lashbits/silicon-toaster/py/README.md

# silicontoaster python package

This is a python package for interacting with a Silicon Toaster device.
