lashbits/silicon-toaster/hw/updated_bom.pdf

Refs | Value | Quantity | SKU | Sinuss | Digikey | Price Sinuss | Price Digikey
C1, C2, C3, C4, C5, C8, C9, C16, C17, C42 | 0.1uF, 25V | 10 | MC0603B104K250CT | 1759037 (https://sinuss.nl/products/mc0603b104k250ct-cap-01uf-25v-10-x7r-0603-multicomp-pro) | not listed alternatives (https://www.digikey.nl/short/33pb599q) my choice (https://www.digikey.nl/nl/products/detail/kyocera-avx/LD033C104KAB2A/1564728) | 1.5€
C6, C7, C10, C11, C12, C13, C14 | 2.2uF | 7 | GRM188R61E225KA12D | 1845734 (https://sinuss.nl/products/grm188r61e225ka12d-cap-22uf-25v-10-x5r-0603-murata) | 490-10731-2-ND (https://www.digikey.nl/nl/products/detail/murata-electronics/GRM188R61E225KA12D/4905349) | 1.1€ | 0.91€
C15 | 22uF | 1 | GRM21BR61E226ME44L | 1907510 (https://sinuss.nl/products/grm21br61e226me44l-cap-22uf-25v-20-x5r-0805-murata) | 490-10749-2-ND (https://www.digikey.nl/nl/products/detail/murata-electronics/GRM21BR61E226ME44L/4905535) | 0.36€ | 0.34€
C18, C19, C20, C21 | 0.15uF | 4 | C2225X154KDRACTU | 2676668 (https://sinuss.nl/products/c2225x154kdractu-cap-015uf-1-kv-10-x7r-2225-kemet) | 399-C2225X154KDRAC7800TR-ND (https://www.digikey.nl/nl/products/detail/kemet/C2225X154KDRAC7800/4172917) | 15.52€ | 11.44€
C22, C23, C24, C25, C26, C27, C28, C29, C30, C31, C32, C33, C34, C35, C36, C37, C38, C39, C40, C41 | 0.1uF | 20 | C2225C104KFRACTU | 2676659 (https://sinuss.nl/products/c2225c104kfractu-cap-01uf-15-kv-10-x7r-2225-kemet) | 399-C2225C104KFRAC7800TR-ND (https://www.digikey.nl/nl/products/detail/kemet/C2225C104KFRAC7800/4172913) 399-18116-2-ND (https://www.digikey.nl/nl/products/detail/kemet/C2225C104KFRACAUTO/9343294) | 104.39€ | 43.46€
D1, D2, D3, D4, D6, D9 | 1A 800V | 6 | US1K-E3/61T | 2335178 (https://sinuss.nl/products/us1k-e361t-rectifier-fast-1a-800v-do-214ac-2-vishay) | US1K-E3/61TGITR-ND (https://www.digikey.nl/nl/products/detail/vishay-general-semiconductor-diodes-division/US1K-E3-61T/1119543) | 3.54€ | 2.04€
D5 | 40V 1A | 1 | MBRM140T3 | 1459068 (https://sinuss.nl/products/mbrm140t3g-diode-schottky-1a-powermite-onsemi) | MBRM140T3OSTR-ND (https://www.digikey.nl/nl/products/detail/onsemi/MBRM140T3/660717) (unavailable) 150-UPS5819E3/TR7TR-ND (https://www.digikey.nl/en/products/detail/microchip-technology/UPS5819E3-TR7/740140) (alternative) | 0.89€ | 0.41€

D7 | red, 20mA, 2V, 0603 | 1 | KPT-1608EC | 2099221 (https://sinuss.nl/products/kpt-1608ec-led-0603-red-15mcd-625nm-kingbright) | not listed alternatives (https://www.digikey.nl/short/7z9749zj) my choice (https://www.digikey.nl/nl/products/detail/liteon/LTST-C191KRKT/386837) | 0.29€
D8 | green, 20mA, 2.1V, 0603 | 1 | KPT-1608CGCK | 2099220 (https://sinuss.nl/products/kpt-1608cgck-led-green-0603-smd-kingbright) | not listed alternatives (https://www.digikey.nl/short/w0pnd3zm) my choice (https://www.digikey.nl/nl/products/detail/liteon/LTST-C191GKT/386829) (get same supplier as red above) | 0.32€
J1 | USB micro | 1 | 629105150521 | 2470822 (https://sinuss.nl/products/629105150521-micro-usb-20-type-b-receptacle-th-wurth-elektronik) | 732-5960-2-ND (https://www.digikey.nl/nl/products/detail/w%C3%BCrth-elektronik/629105150521/5047751) | 3.36€ | 2.01€
J2, J3, J6 | Coax | 3 | SMA-J-P-H-ST-EM3 | 2856819 (https://sinuss.nl/products/sma-j-p-h-st-em3-rf-coaxial-sma-jack-50-ohm-pcb-samtec) (sold out) | SAM9950-ND (https://www.digikey.nl/nl/products/detail/samtec-inc/SMA-J-P-H-ST-EM3/6678687) | 40.65€ | 16.77€
L1 | Ferrite bead | 1 | BLM18PG600SN1D | 1515746 (https://sinuss.nl/products/blm18pg600sn1d-ferrite-bead-01ohm-500ma-0603-murata) | 490-1036-2-ND (https://www.digikey.nl/nl/products/detail/murata-electronics/BLM18PG600SN1D/584247) | 0.14€ | 0.09€
L2 | Inductor 10uH | 1 | LQH43CN100K03L | 1515459 (https://sinuss.nl/products/lqh43cn100k03l-inductor-1812-case-10uh-10-murata) | 490-2519-2-ND (https://www.digikey.nl/nl/products/detail/murata-electronics/LQH43CN100K03L/599911) | 0.78€ | 0.35€
Q1 | Power N Mosfet | 1 | STT6N3LLH6 | 3130139 (https://sinuss.nl/products/stt6n3llh6-power-mosfet-n-channel-30-v-6-a-0-021-ohm-sot-23-surface-mount-stmicroelectronics) | 497-13591-2-ND (https://www.digikey.nl/nl/products/detail/stmicroelectronics/STT6N3LLH6/3910828) | 1.41€ | 0.67€
Q2 | IGBT | 1 | IKW40N120H3FKSA1 | 1832351 (https://sinuss.nl/products/ikw40n120h3fksa1-igbt-diode1200v40ato247-infineon) | IKW40N120H3FKSA1-ND (https://www.digikey.nl/nl/products/detail/infineon-technologies/IKW40N120H3FKSA1/2338027) | 8.46€ | 7.85€
R1, R3, R4, R7 | 10k | 4 | CRGH0603J10K | 2331740 (https://sinuss.nl/products/crgh0603j10k-res-10k-5-02w-0603-thick-film-te-connectivity) | A126394TR-ND (https://www.digikey.nl/nl/products/detail/te-connectivity-passive-product/CRGH0603J10K/2385379) | 0.02€ | 0.09€
R2, R11 | 10m, 50v, 100mW, +-1%, 0603 | 2 | MCWR06W1005FTL | 2447232 (https://sinuss.nl/products/mcwr06w1005ftl-res-10m-1-01w-thick-film-multicomp-pro-1) | not listed alternatives (https://www.digikey.nl/short/ffhbw5r7) my choice (https://www.digikey.nl/nl/products/detail/vishay-dale/CRCW060310M0FKEAC/7928470) | 0.06€
R5 | 22k1, 75v, 100mW, 0603 | 1 | MCWR06X2212FTL | 2694776 (https://sinuss.nl/products/mcwr06x2212ftl-res-22k1-1-01w-0603-thick-film-multicomp-pro-1) | not listed alternatives (https://www.digikey.nl/short/p2j4th07) my choice (https://www.digikey.nl/en/products/detail/vishay-dale/CRCW060322K1FKEAC/7924045) | 0.03€
R6 | 2k, 50v, 100mW, 0603 | 1 | MCWR06X2001FTL | 2447319 (https://sinuss.nl/products/mcwr06x2001ftl-res-2k-1-01w-0603-thick-film-multicomp-pro-1) | not listed alternatives (https://www.digikey.nl/short/fb2tmqv2) my choice (https://www.digikey.nl/en/products/detail/vishay-dale/CRCW06032K00FKEAC/7928375) | 0.01€

R8, R10 | 64r9 | 2 | CRCW060364R9FKEA | 2141257 (https://sinuss.nl/products/crcw060364r9fkea-res-64r9-1-01w-0603-thick-film-vishay) | 541-64.9HTR-ND (https://www.digikey.nl/nl/products/detail/vishay-dale/CRCW060364R9FKEA/1174533) | 0.20€ | 0.18€
R9 | 4r99 | 1 | CRCW06034R99FKEA | 2616753 (https://sinuss.nl/products/crcw06034r99fkea-res-4r99-1-01w-0603-thick-film-vishay) | 541-4.99HHTR-ND (https://www.digikey.nl/nl/products/detail/vishay-dale/CRCW06034R99FKEA/1961616) | 0.09€ | 0.09€
U1 | STM32 | 1 | STM32F205RET6 | 2060897 (https://sinuss.nl/products/stm32f205ret6-mcu-32bit-cortex-m3-120mhz-lqfp-64-stmicroelectronics) | 497-11155-ND (https://www.digikey.nl/nl/products/detail/stmicroelectronics/STM32F205RET6/2640801) | 19.14€ | 10.79€
U2 | FTDI | 1 | FT232RL | unlisted (also on Farnell) | 768-1007-2-ND (https://www.digikey.nl/nl/products/detail/ftdi-future-technology-devices-international-ltd/FT232RL-REEL/1836385) | | 4.38€
U3 | 1A, 1.2Mhz | 1 | MIC2288YD5-TR | 2509929 (https://sinuss.nl/products/mic2288yd5-tr-voltage-reg-boost-1a-12mhz-tsot23-5-microchip) | 576-1729-2-ND (https://www.digikey.nl/nl/products/detail/microchip-technology/MIC2288YD5-TR/1028498) | 1.29€ | 0.67€
U4, U5 | 3.3v regulator | 2 | LD1117S33TR | 1202826 (https://sinuss.nl/products/ld1117s33tr-ldo-voltage-regulator-fixed-4-75v-to-15v-1-1v-dropout-3-3vout-950maout-sot-223-3-stmicroelectronics) (sold out) | 497-1242-2-ND (https://www.digikey.nl/nl/products/detail/stmicroelectronics/LD1117S33TR/585766) | 2.06€ | 1.14€
U6 | Mosfet driver | 1 | MCP1407-E/SN | 1332080 (https://sinuss.nl/products/mcp1407-e-sn-dual-mosfet-driver-ic-driver-low-side-4-5v-18v-supply-6a-out-40ns-delay-soic-8-microchip) | MCP1407-E/SN-ND (https://www.digikey.nl/nl/products/detail/microchip-technology/MCP1407-E-SN/1228639) | 2.41€ | 1.25€
U7 | Transformer | 1 | SCS-200L (https://www.coilcraft.com/en-us/products/transformers/power-transformers/current-sensing/scs/scs-200l/) | 2526945 (https://sinuss.nl/products/scs-200l-current-sense-transformer-30a-1mhz-coilcraft) (sold out) | not listed | 5.09€
U8 | or gate | 1 | 74LVC1G32GW,125 | 1631689 (https://sinuss.nl/products/74lvc1g32gw125-ic-logic-74lvc1g-or-gate-umt5-nexperia) | 1727-3102-2-ND (https://www.digikey.nl/nl/products/detail/nexperia-usa-inc/74LVC1G32GW-125/946688) | 0.76€ | 0.33€
