lashbits/silicon-toaster/hw/emfi.step

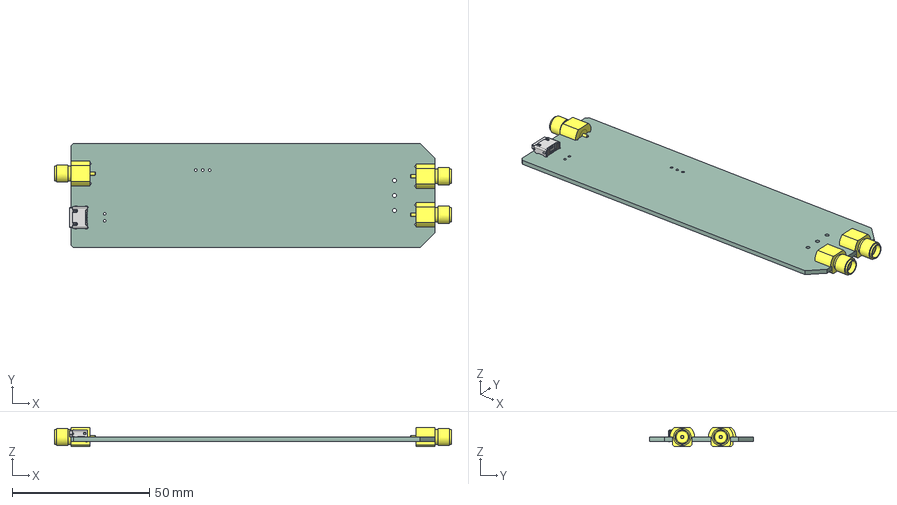
[picture p1: CAD file, 2023-12-07]
hw/emfi.step
144.4 x 38.0 x 7.00 mm
emfi PCB
