lashbits/silicon-toaster/hw/models/LED_0603.step

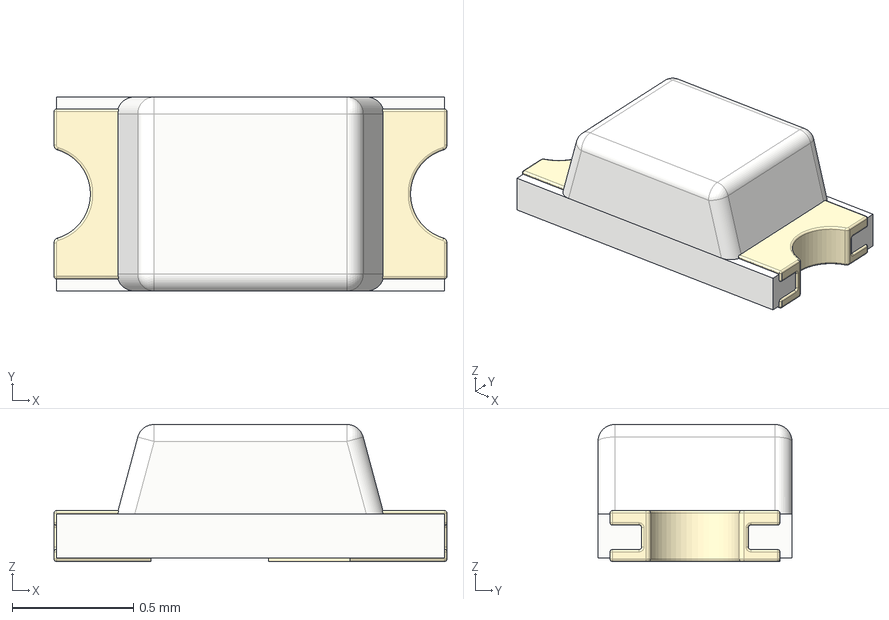
[picture p2: CAD file, 2024-01-06]
hw/models/LED_0603.step
1.62 x 0.8 x 0.565 mm
Cover
Cover_Mini
Insides
