lashbits/silicon-toaster/hw/models/to-247-3-bend.step

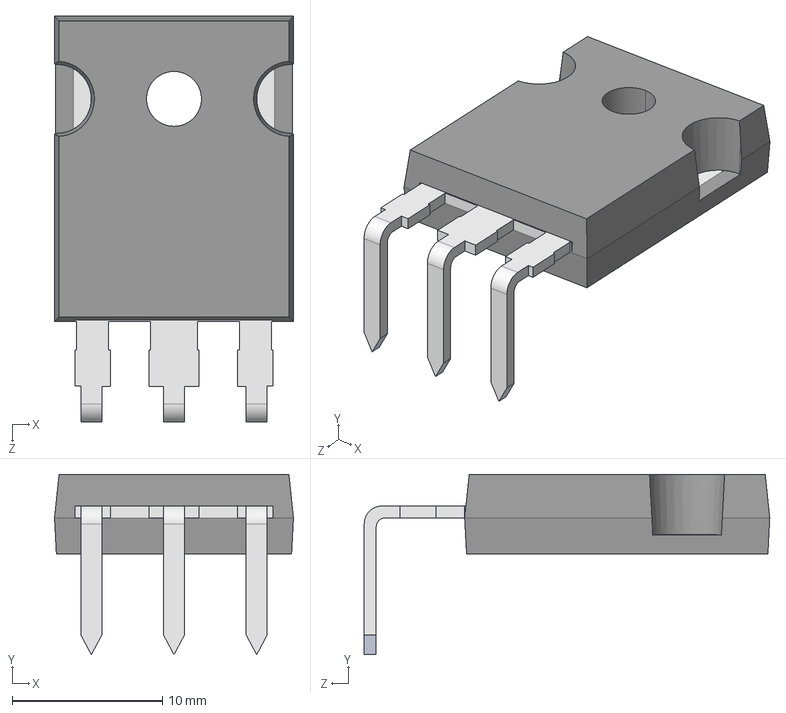
[picture p3: CAD file, 2024-01-06]
hw/models/to-247-3-bend.step
15.9 x 12.0 x 27.0 mm
