lashbits/silicon-toaster/hw/models/Coilcraft-SCS-xxxL.step

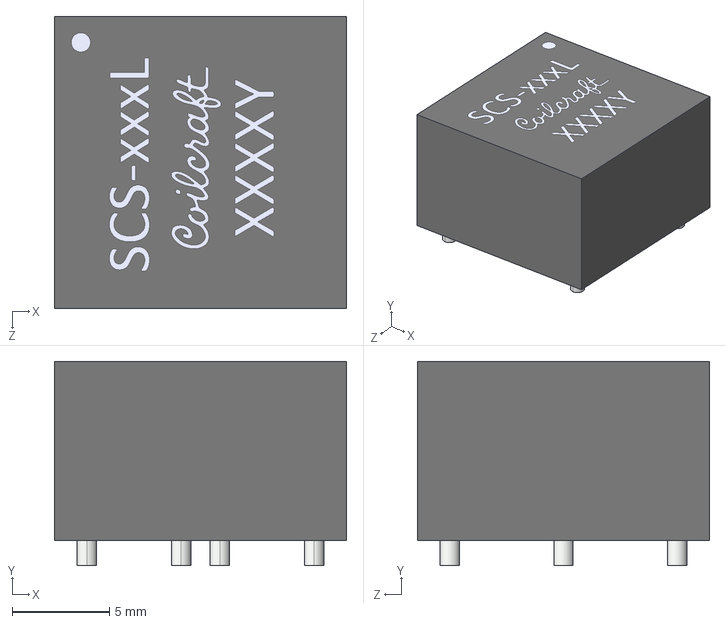
[picture p4: CAD file, 2024-01-06]
hw/models/Coilcraft-SCS-xxxL.step
15.0 x 10.5 x 15.0 mm
