lashbits/silicon-toaster/hw/models/SMA-J-P-H-ST-EM3.stp

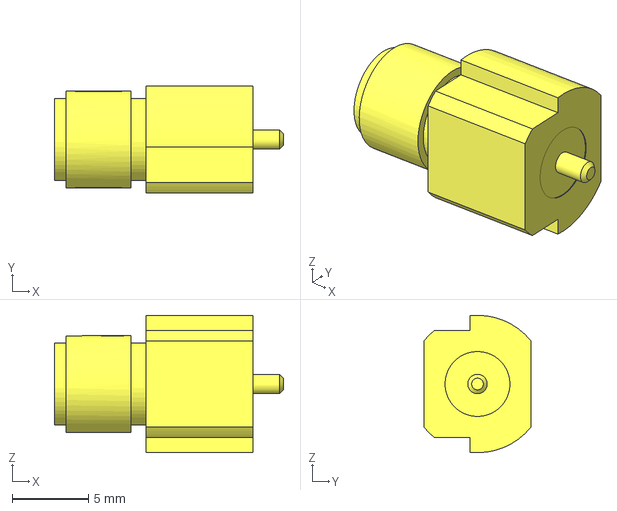
[picture p5: CAD file, 2024-01-06]
hw/models/SMA-J-P-H-ST-EM3.stp
15.0 x 7.00 x 9.00 mm
