lashbits/silicon-toaster/hw/models/wurth-629105150521.stp

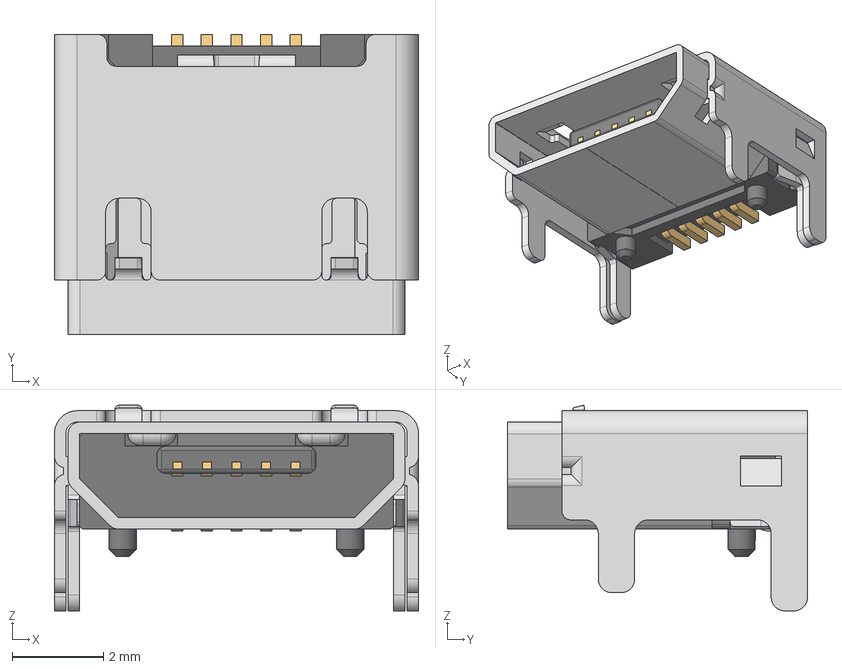
[picture p6: CAD file, 2024-01-06]
hw/models/wurth-629105150521.stp
8.00 x 6.60 x 4.52 mm
629105150521_Housing
629105150521_Pin1 x 4
629105150521_Pin2
629105150521_Shielding2
629105150521_Shielding
