lashbits/silicon-toaster/(commit log)

2023-12-04 update various files to kicad 7
    [analog.kicad_sch, cbank.kicad_sch, emfi.kicad_pcb, emfi.kicad_sch, ft232.kicad_sch, mcu.kicad_sch, power.kicad_sch]
2023-12-04 new gerbers
    [emfi-B_Cu.gbr, emfi-B_Mask.gbr, emfi-B_Paste.gbr, emfi-B_Silkscreen.gbr, emfi-Edge_Cuts.gbr, emfi-F_Cu.gbr, emfi-F_Mask.gbr, emfi-F_Paste.gbr]
2023-12-04 fixes to bom.py
2023-12-07 add pcb step file
    [emfi.step]
2023-12-16 fix capacitor value in updated_bom.pdf
2024-01-04 replace wrl with step files in 3d models of components
    [Coilcraft-SCS-xxxL.step, LED_0603.step, SMA-J-P-H-ST-EM3.stp, emfi.kicad_pcb, to-247-3-bend.step, wurth-629105150521.stp]
2024-04-05 fix plot-calibration.py
2024-04-05 fix calibrate.py
2024-04-05 move calibration files to own directory
2024-11-29 calibration scripts
